kele8864879/ENEL417-Group8-/Project_Submittion/Website_Code/images.jpg

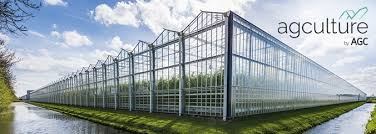
Project_Submittion/Website_Code/images.jpg
