kele8864879/ENEL417-Group8-/README.md

# ENEL417-Group8-

All of code file is saved in Project submittion. All of schamatic, block diagram, code diagram, and datasheet are saved in build demo. Please ignore other repository
