kele8864879/ENEL417-Group8-/Project_Submittion/Cubeide_Code/README.md

# ENEL417-Group8-

Main Board has the code for all system except light elevation part because the light elevation part is written in
second board
