kele8864879/ENEL417-Group8-/Project_Submittion/Cubeide_Code/417_Project (Main_Board)/Read_me.txt

It is the code for main borad. Main board take charge of every function unless light elevation.
