kele8864879/ENEL417-Group8-/Project_Submittion/Cubeide_Code/417_Project_ligh_elevation_(Second Board)/Read_me.txt

It is the second board code. The second board is responsible for the light elevation. It receive 00, 01 ,10, 11 GPIO
Information from main board, then it lift LED bar to 4cm, 8cm, 12cm, 16cm.
