kele8864879/ENEL417-Group8-/Build_demo/Block Diagrams/System Function Diagram.docx

1. System Block Diagram

Keyboard and LCD

Micro-controller

Temperature module

Heating/Cooling function

Illumination function

Illumination module

Watering function

Humidity module

Distance module

Lifting Function

Database

Remote control/HMI

2. Temperature Part Block Diagram

Heater and Fan

Dual High- power Mosfet

Cooling Fan

24V power supply

Dual High- power Mosfet

Keyboard Input

Micro-controller

LM 35 Temperature senor

Analog to Digital Converter

3. Watering Part Block Diagram

5V DC water pump

Remote Control

Keyboard Input

Analog to Digital Converter

Micro-controller

5V Relay

Moisture sensors

4. Illumination Part Block Diagram

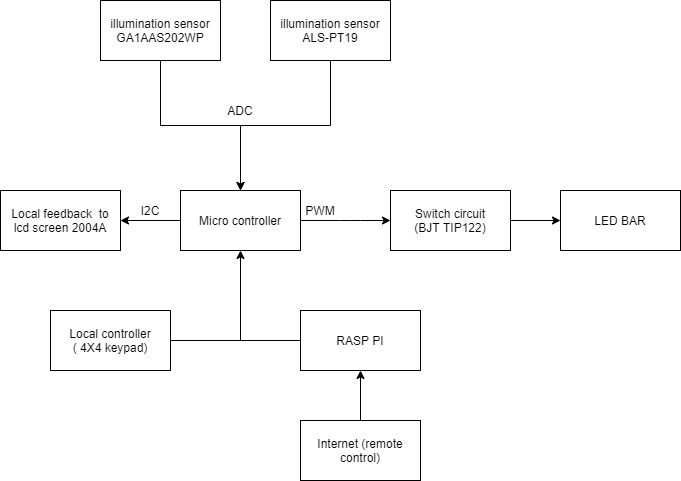
[picture p2: figure]

5. Lifting Part Block Diagram

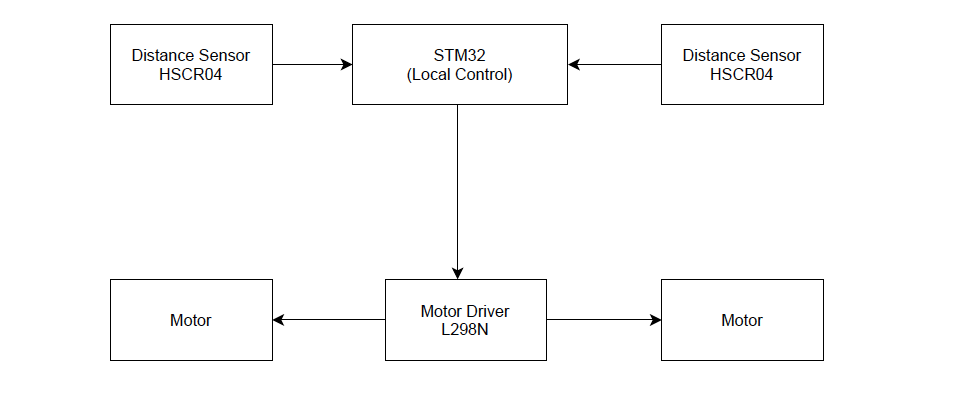
[picture p3: figure]

6. Remote Control Block Diagram

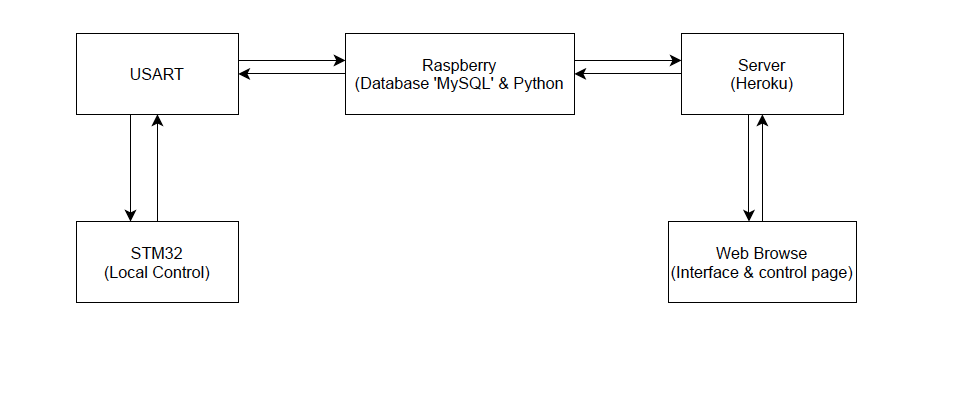
[picture p4: figure]

7. Local Control Block Diagram

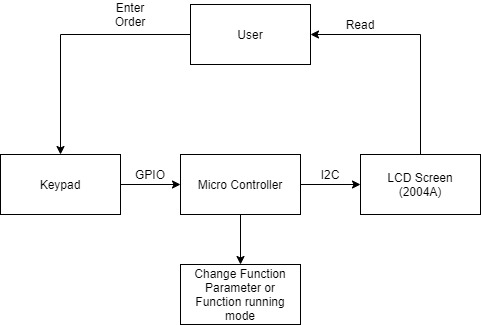
[picture p5: figure]
