kele8864879/ENEL417-Group8-/Build_demo/Code diagrams & pseudo-code/website_diagram.pdf

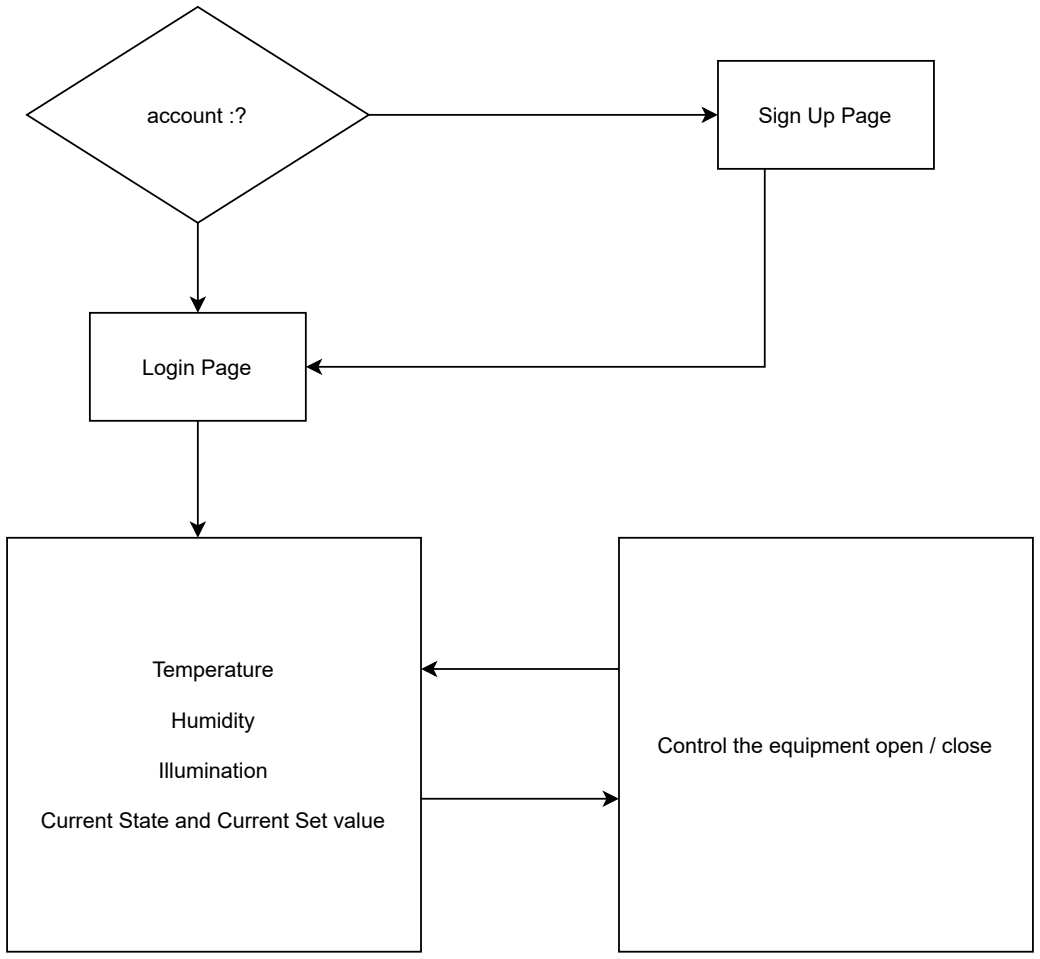
[picture p6: figure]
Temperature; Humidity; Illumination; Current State and Current Set value; Control the equipment open / close; account :?; Sign Up Page; Login Page
