kele8864879/ENEL417-Group8-/Build_demo/Code diagrams & pseudo-code/Total main running logic.pdf

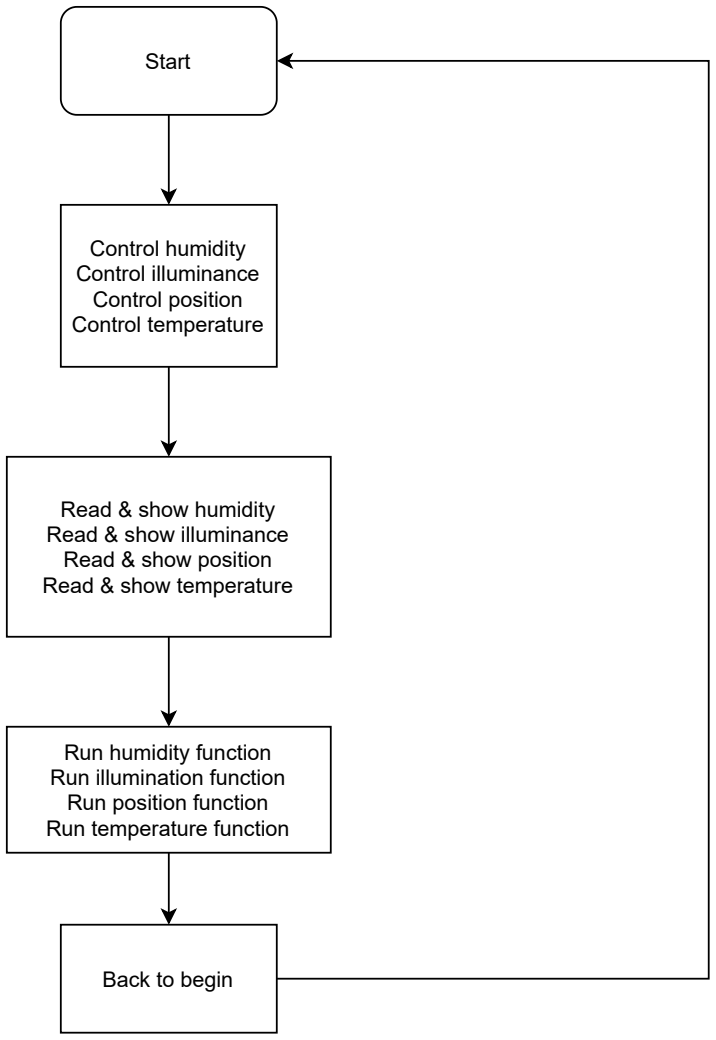
[picture p7: figure]
Control humidity Control illuminance Control position Control temperature; Read & show humidity Read & show illuminance Read & show position Read & show temperature; Run humidity function Run illumination function Run position function Run temperature function; Start; Back to begin
