kele8864879/ENEL417-Group8-/Build_demo/Code diagrams & pseudo-code/Remote_Control_Flow_Chart.pdf

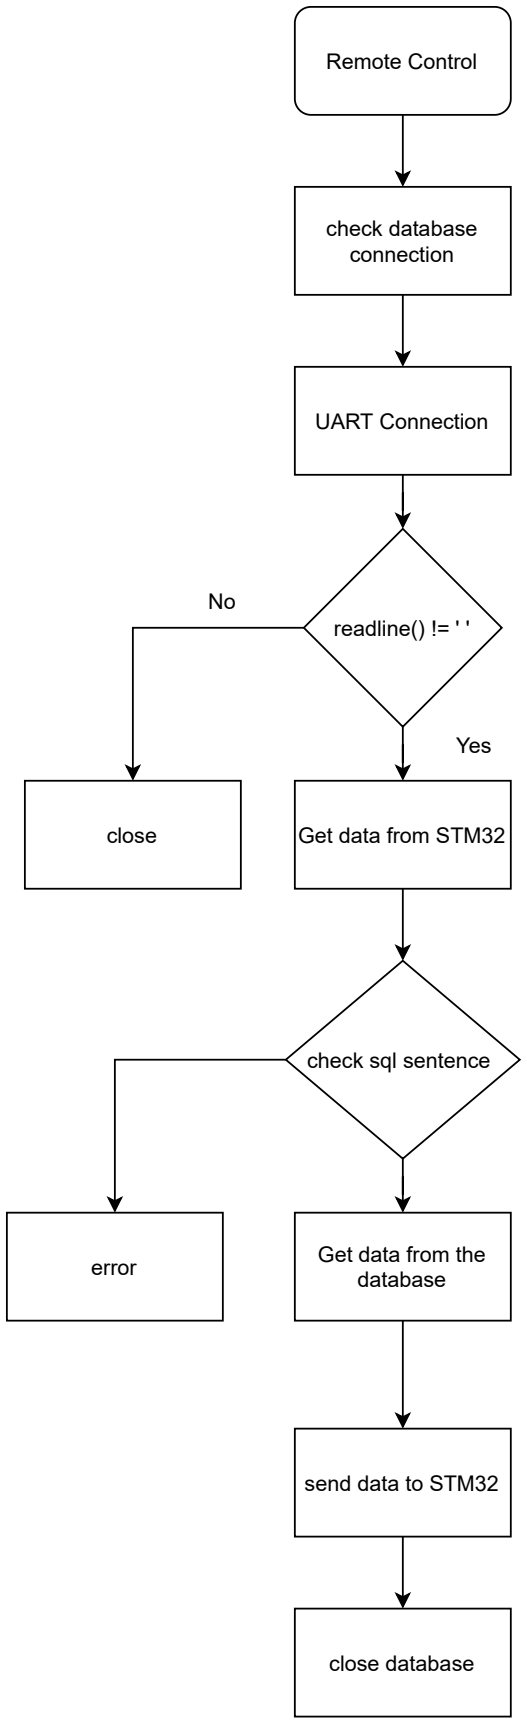
[picture p8: figure]
check database connection; Remote Control; UART Connection; readline() != ' '; close; Get data from STM32; check sql sentence; Get data from the database error; send data to STM32; Yes; close database
