kele8864879/ENEL417-Group8-/Build_demo/Circuit/CIRCUIT.pdf

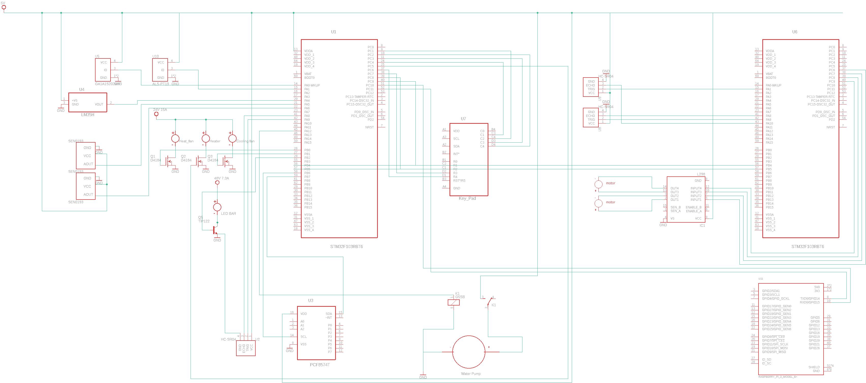
[picture p10: page 1]
