kele8864879/ENEL417-Group8-/Build_demo/Code diagrams & pseudo-code/Lifting_Flow_Chart.pdf

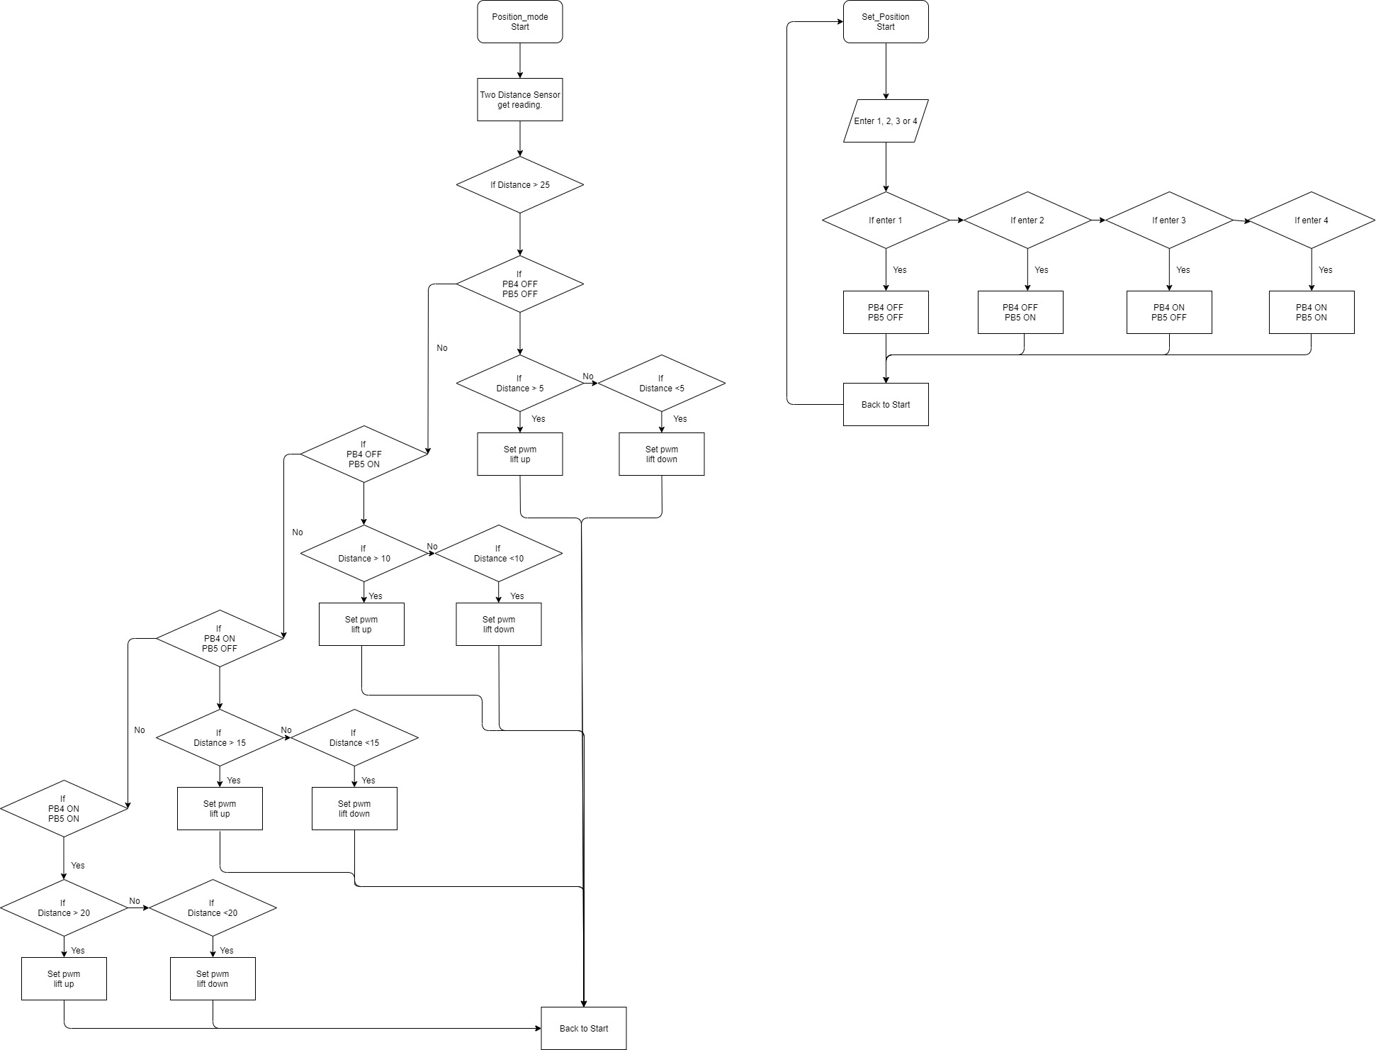
[picture p11: page 1]
