kele8864879/ENEL417-Group8-/Build_demo/Code diagrams & pseudo-code/illumination_flow_chart.pdf

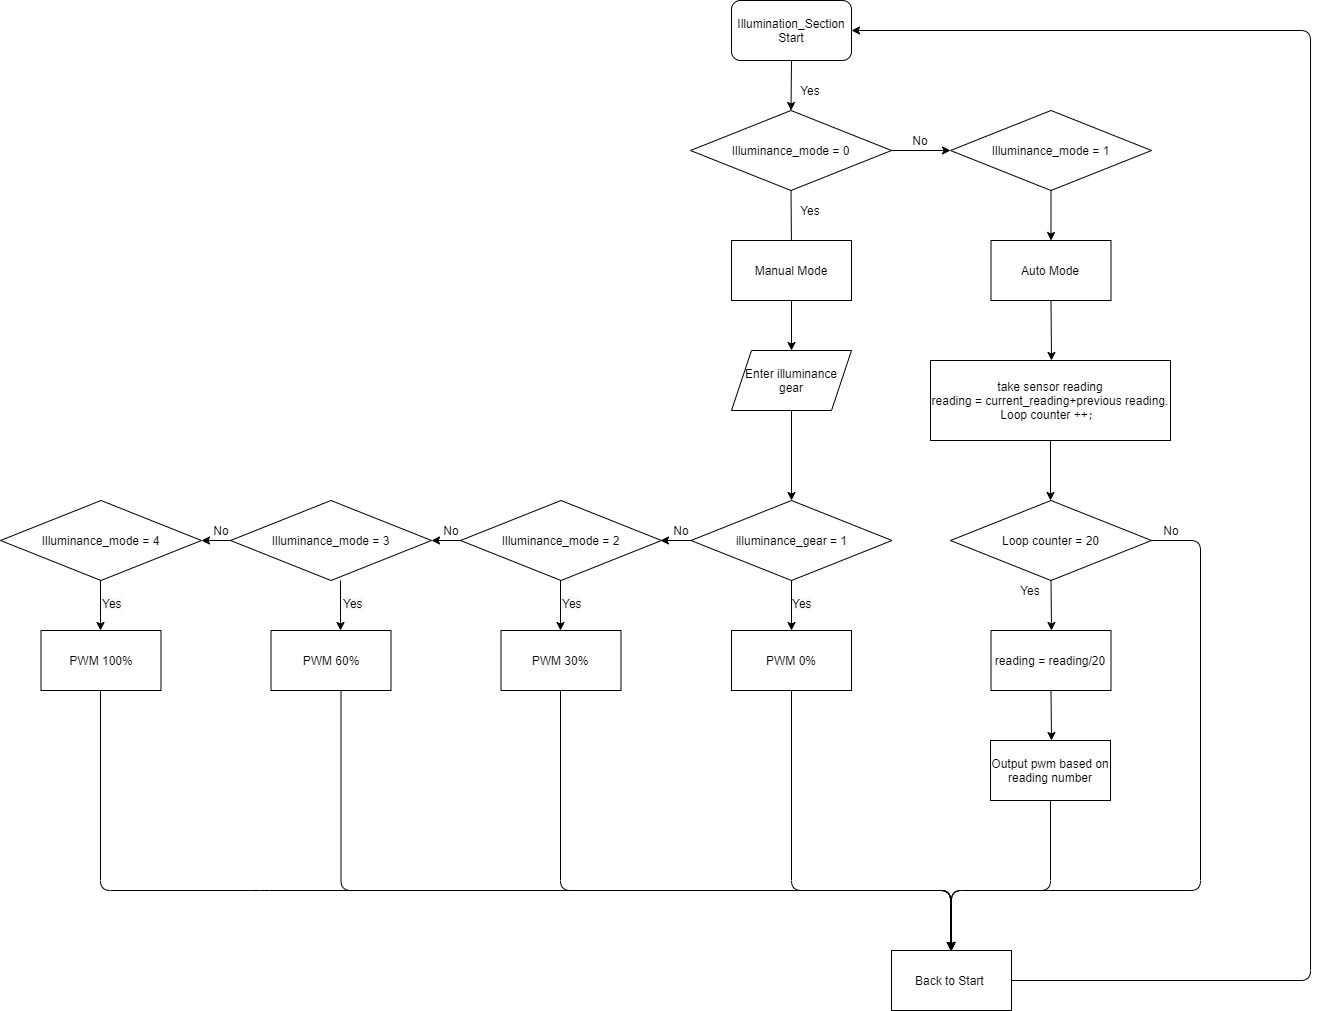
[picture p12: page 1]
