kele8864879/ENEL417-Group8-/Build_demo/Code diagrams & pseudo-code/Local_Control_Floa_Chart.pdf

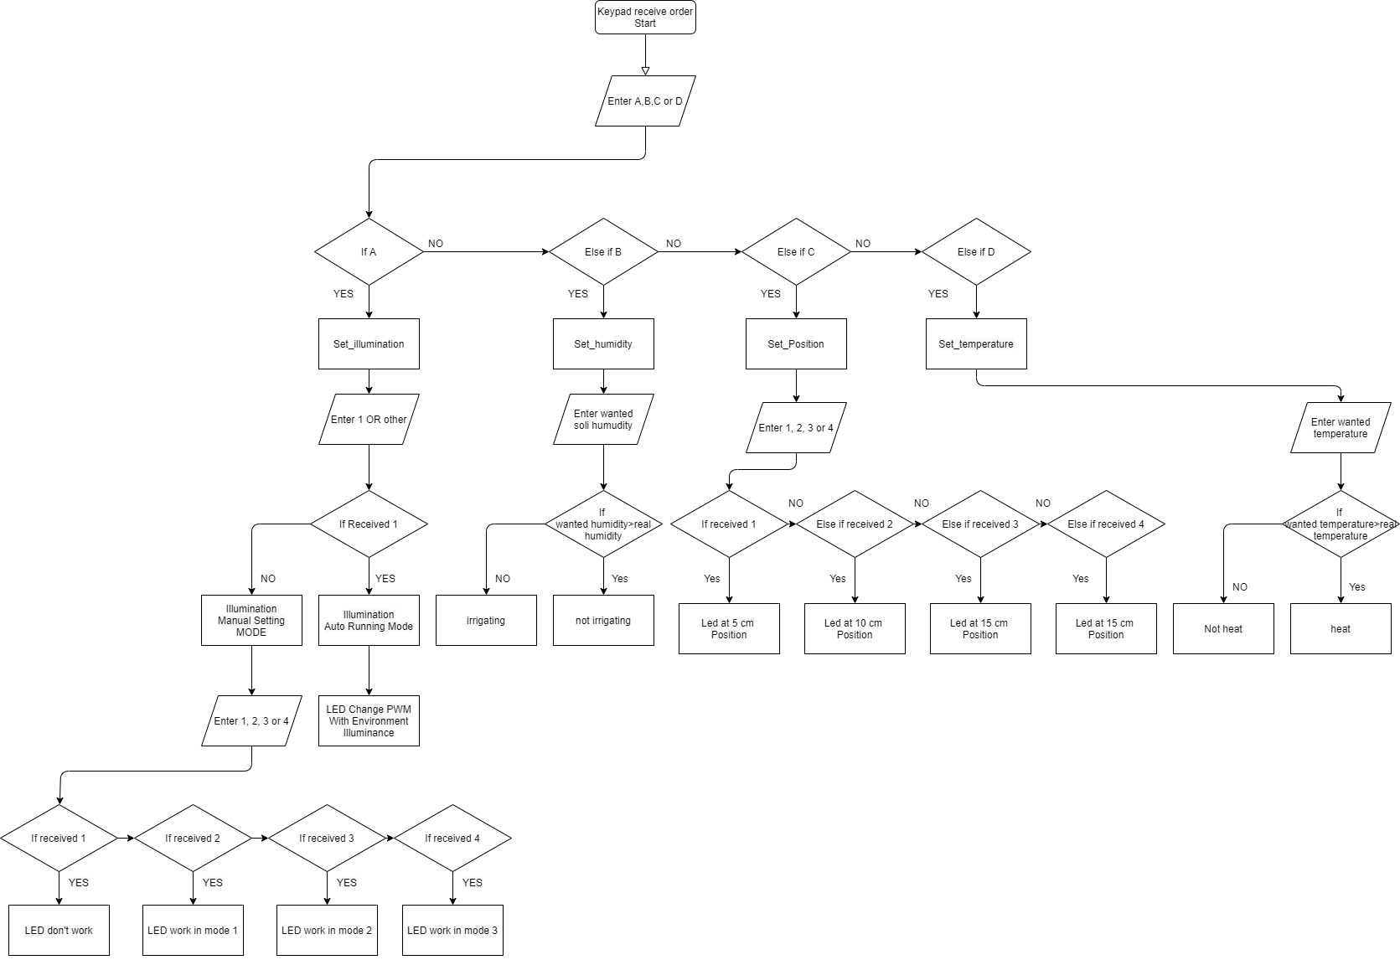
[picture p13: page 1]
