kele8864879/ENEL417-Group8-/Build_demo/Code diagrams & pseudo-code/database.pdf

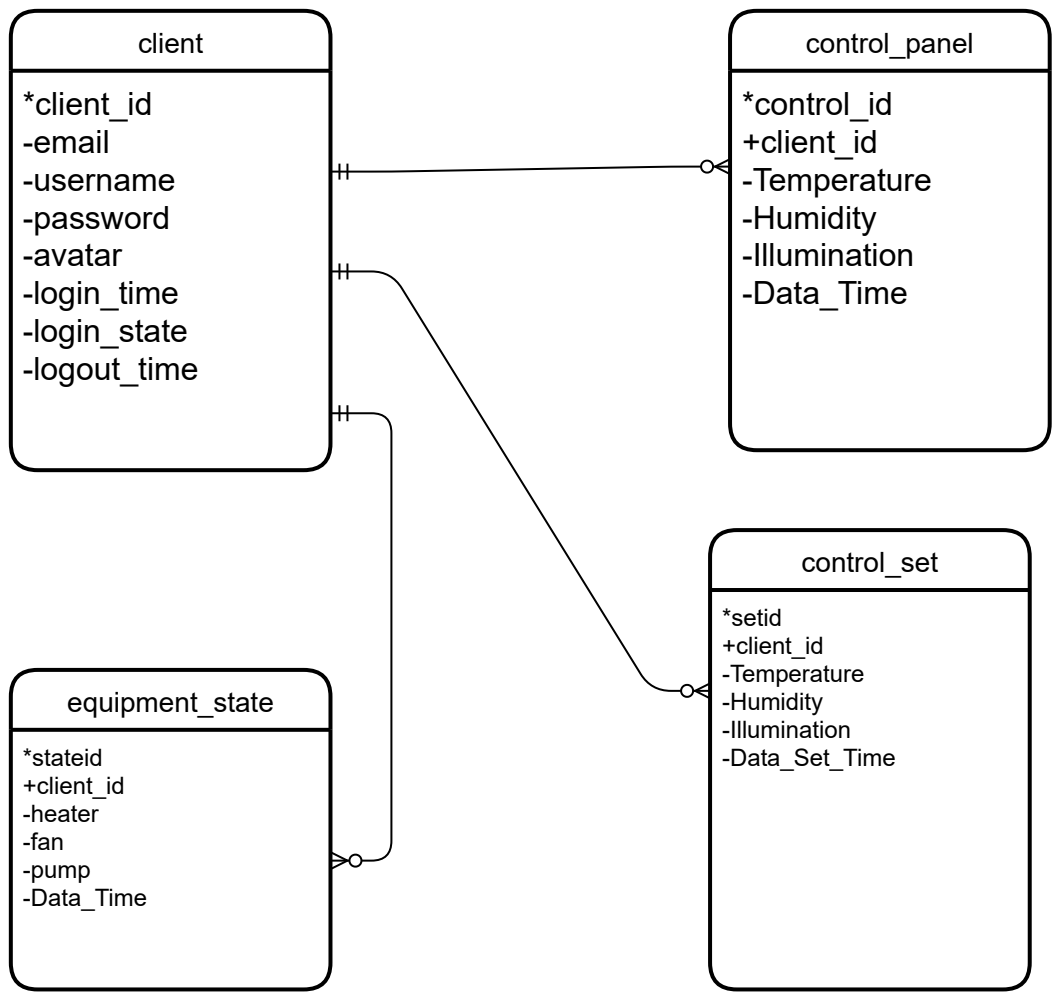
[picture p14: page 1]
client; *client_id -email -username -password -avatar -login_time -login_state -logout_time; control_panel; *control_id +client_id -Temperature -Humidity -Illumination -Data_Time; control_set; *setid +client_id -Temperature -Humidity -Illumination -Data_Set_Time; equipment_state; *stateid +client_id -heater -fan -pump -Data_Time
