kele8864879/ENEL417-Group8-/Build_demo/Code diagrams & pseudo-code/humidity_code_diagram.pdf

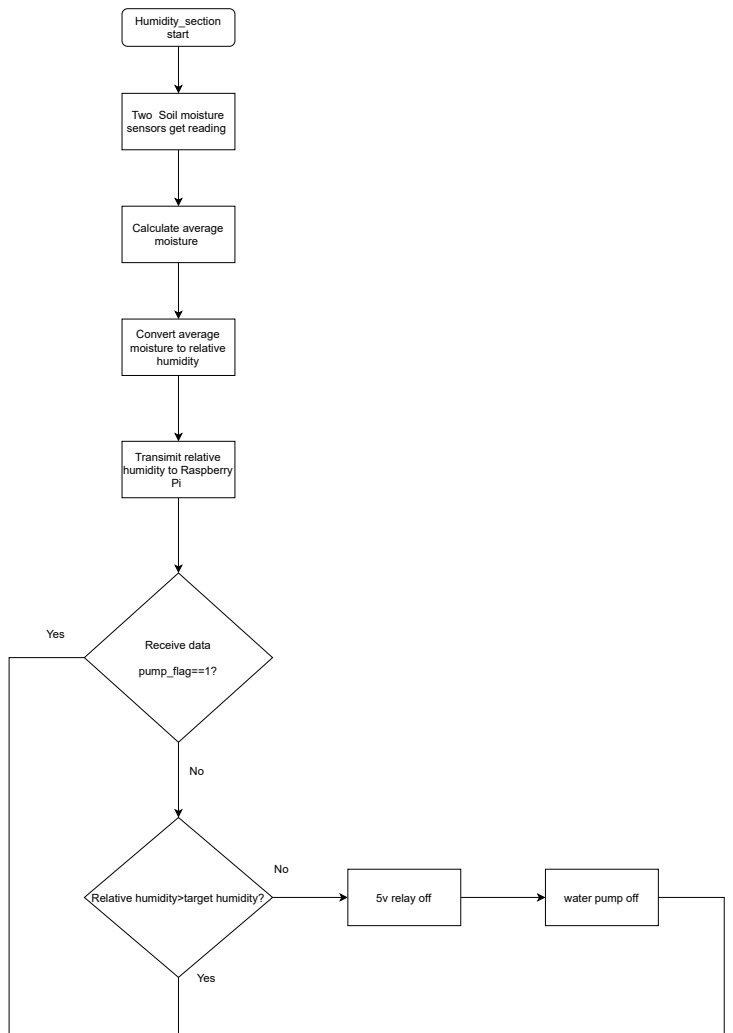
[picture p15: page 1]
Humidity_section start; Calculate average moisture; Relative humidity>target humidity?; 5v relay off; water pump off; Yes; Receive data; pump_flag==1?

Two Soil moisture
sensors get reading

Convert average
moisture to relative
humidity

Transimit relative
humidity to Raspberry

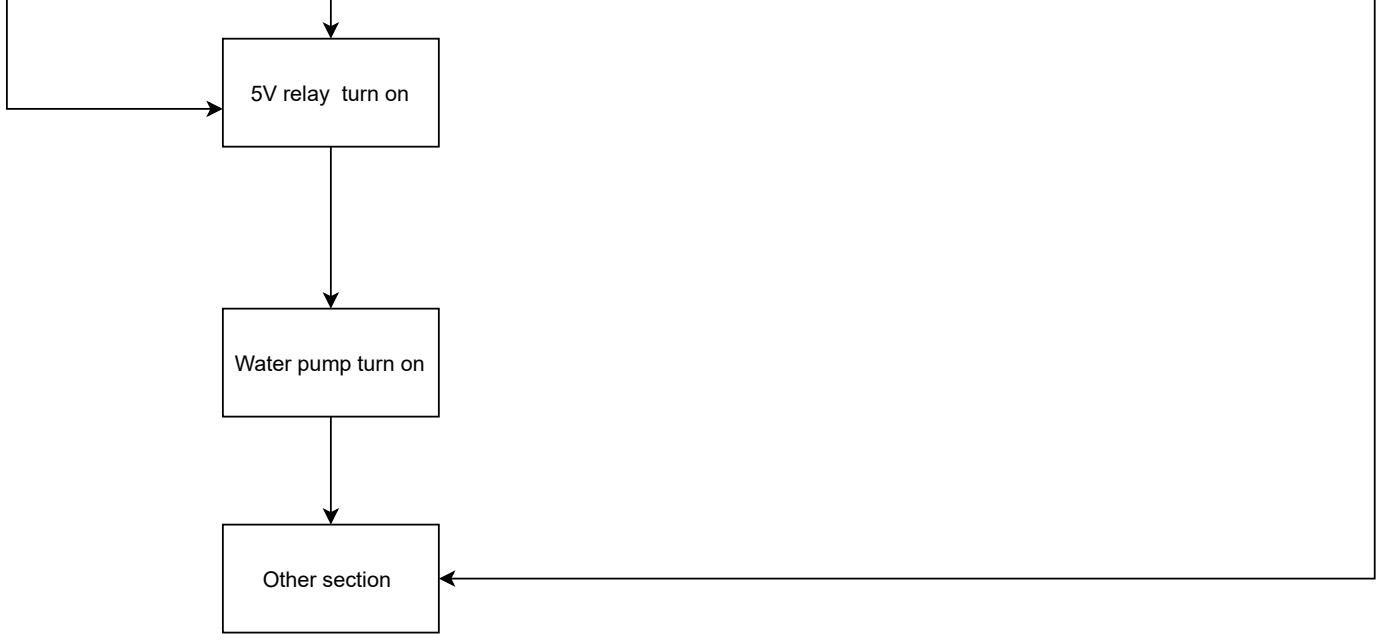
[picture p16: figure]
5V relay turn on; Water pump turn on; Other section
