kele8864879/ENEL417-Group8-/Fuyang/untitled.sch

## EAGLE design Fuyang/untitled.sch (2021-03-26)

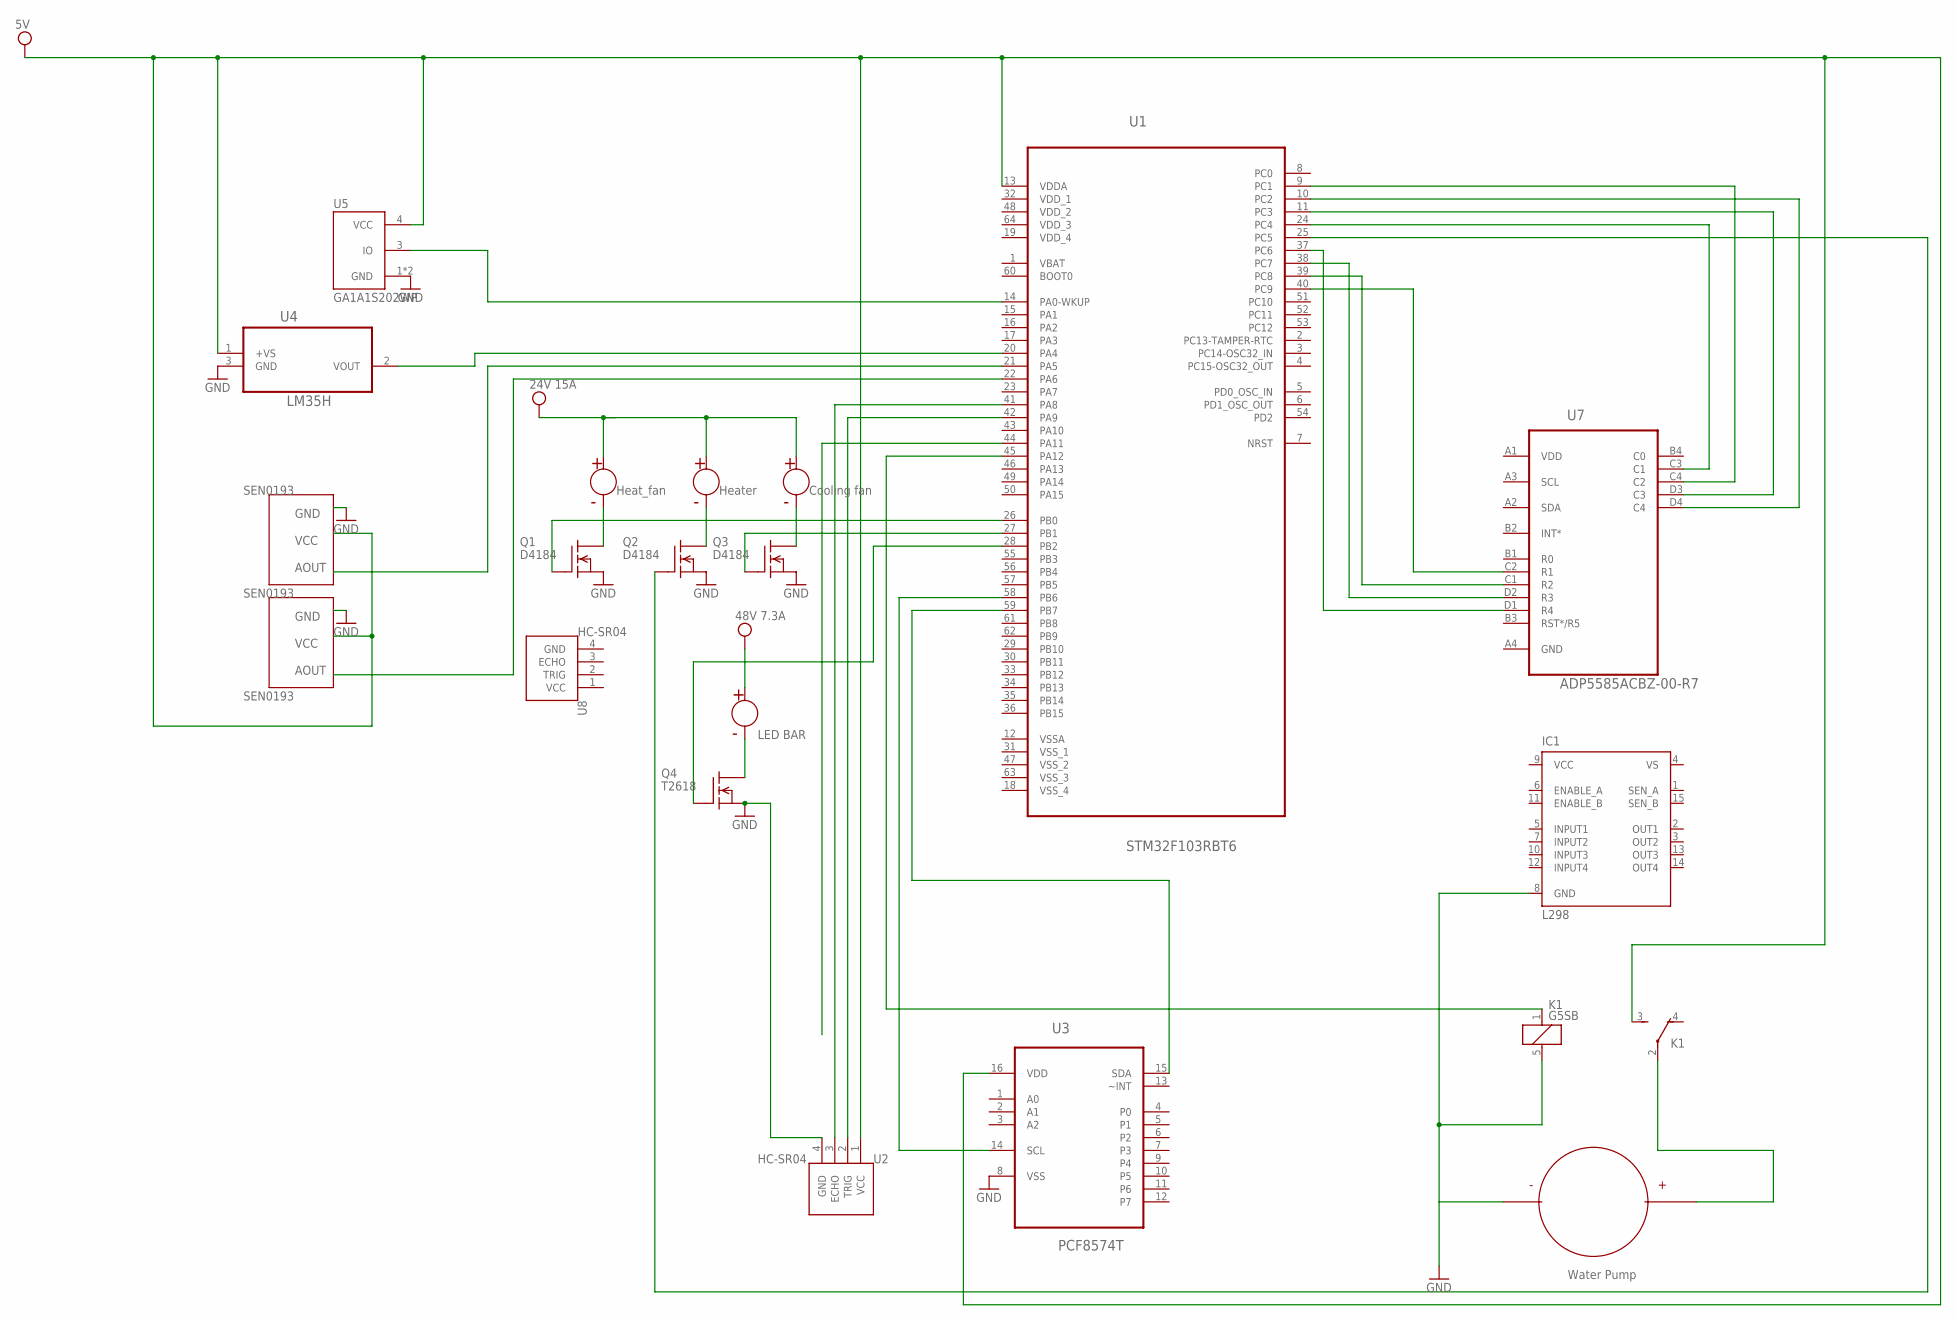
[picture p17: schematic untitled.sch]

Parts:
IC1: L298; MULTIWATT-15
K1: G5SB
Q1, Q2, Q3: D4184; TO92
Q4: T2618; TO92
U1: STM32F103RBT6; QFP50P1200X1200X160-64N
U2, U8: HC-SR04; XCVR_HC-SR04
U3: PCF8574T; SOIC127P1032X265-16N
U4: LM35H; TO127P543X266-3P
U5: GA1A1S202WP; XDCR_GA1A1S202WP
U7: ADP5585ACBZ-00-R7; BGA16C40P4X4_159X159X54

Connections:
GND: IC1.8 (GND), K1.5 (2), Q1.1 (S), Q2.1 (S), Q3.1 (S), Q4.1 (S), U2.4 (GND), U3.8 (VSS), U4.3 (GND), U5.1 (GND)
unnamed: U1.14 (PA0-WKUP), U5.3 (IO)
unnamed: U1.20 (PA4), U4.2 (VOUT)
unnamed: K1.1, U1.45 (PA12)
unnamed: U1.24 (PC4), U7.C3 (C1)
unnamed: Q1.2 (G), U1.26 (PB0)
unnamed: Q2.2 (G), U1.25 (PC5)
unnamed: Q3.2 (G), U1.27 (PB1)
unnamed: Q4.2 (G), U1.28 (PB2)
unnamed: U1.41 (PA8), U2.3 (ECHO)
unnamed: U1.42 (PA9), U2.2 (TRIG)
unnamed: U1.58 (PB6), U3.14 (SCL)
unnamed: U1.59 (PB7), U3.15 (SDA)
unnamed: U1.40 (PC9), U7.C2 (R1)
unnamed: U1.39 (PC8), U7.C1 (R2)
unnamed: U1.38 (PC7), U7.D2 (R3)
unnamed: U1.37 (PC6), U7.D1 (R4)
unnamed: U1.9 (PC1), U7.C4 (C2)
unnamed: U1.11 (PC3), U7.D3 (C3)
unnamed: U1.10 (PC2), U7.D4 (C4)
VCC: K1.3 (S), U1.13 (VDDA), U2.1 (VCC), U3.16 (VDD), U4.1 (+VS), U5.4 (VCC)

Notes on the sheet:
GND VCC AOUT
SEN0193
Heat_fan
Heater
Cooling fan
LED BAR
Water Pump
