kele8864879/ENEL417-Group8-/Zhelin/main.c

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
/* Includes ------------------------------------------------------------------*/
#include "main.h"
#include "adc.h"
#include "dma.h"
#include "i2c.h"
#include "tim.h"
#include "usart.h"
#include "gpio.h"

/* USER CODE BEGIN Includes */
#include "stdio.h"	//printf function
#include "string.h"
#include "stdlib.h"
#include <math.h>
/* USER CODE END Includes */


void SystemClock_Config(void);
/* USER CODE BEGIN 0 */
#ifdef __GNUC__
#define PUTCHAR_PROTOTYPE int __io_putchar(int ch)
#else
#define PUTCHAR_PROTOTYPE int fputc(int ch, FILE *f)
#endif

PUTCHAR_PROTOTYPE
{
    HAL_UART_Transmit(&huart2, (uint8_t *)&ch, 1 , 0xffff);
    return ch;
}

#define PB4_ON HAL_GPIO_WritePin(GPIOB, GPIO_PIN_4, GPIO_PIN_SET); //
#define PB4_OFF HAL_GPIO_WritePin(GPIOB, GPIO_PIN_4, GPIO_PIN_RESET); //
#define PB5_ON HAL_GPIO_WritePin(GPIOB, GPIO_PIN_5, GPIO_PIN_SET); //
#define PB5_OFF HAL_GPIO_WritePin(GPIOB, GPIO_PIN_5, GPIO_PIN_RESET); //

uint32_t IC_Val1 = 0;
uint32_t IC_Val2 = 0;
uint32_t Difference = 0;
uint8_t Is_First_Captured = 0;  // is the first value captured ?
uint8_t Distance  = 0;
// dma adc_buffer
uint16_t adc_buf[4];



//humidity part
const float air_humidity=3400;
const  float water_humidity=1680;
uint8_t key;
float humidity;
float humidity1;
char RH[10];
char set_humidity[10];	//for humidity function
char set_data[10]; 		// for wanted distance, light power, and distance
//int light_power = 0;
int position_gear;
int position_flag = 1;
float ilu_mode; //0 for auto mode, 1 for manual gear
float target_TEMP = 19;
float target_RH=40;
float avg_humidity;
int pump_flag=0;
int fan_flag=0;
int heater_flag=0;
////////////////////////////////////////////
uint8_t cliBufferTX[200];
uint8_t cliBufferRX[11];

/*
void Opearation_Fan() //括号内添加网页传过来的参数
{
	if(fan_flag == '1')
	{
		HAL_GPIO_WritePin(GPIOA,GPIO_PIN_12,GPIO_PIN_RESET); //Fans GPIOA OPEN
		__HAL_TIM_SET_COMPARE(&htim3,TIM_CHANNEL_3,3) pwm 50%

	}
	else if (fan_flag == '0')
	{
		HAL_GPIO_WritePin(GPIOA,GPIO_PIN_12,GPIO_PIN_RESET); //Fans GPIOA CLOSE
		__HAL_TIM_SET_COMPARE(&htim3,TIM_CHANNEL_3,3) pwm off
	}
	else
	{
		//自动控制
		//target_temp 获取用户想要的阈值
		//set fan_flag == 2
	}

}

void Operation_Heater() //括号内添加网页传过来的参数
{
	if(heater_flag == '1')
	{
		HAL_GPIO_WritePin(GPIOA,GPIO_PIN_12,GPIO_PIN_RESET); //Heater GPIOA OPEN
		__HAL_TIM_SET_COMPARE(&htim3,TIM_CHANNEL_3,3) pwm 50% //设置pwm在50%


	}
	else if(heater_flag == '0')
	{
		HAL_GPIO_WritePin(GPIOA,GPIO_PIN_12,GPIO_PIN_RESET); //Heater GPIOA CLOSE
		__HAL_TIM_SET_COMPARE(&htim3,TIM_CHANNEL_3,3) pwm off
	}
	else
	{
		//set heater_flag == 2
		//自动控制
		//target_temp 获取用户想要的阈值
	}
}
*/



void Humidity_Read(void)
{
	               humidity= adc_buf[2];//读取湿度
	               humidity1=adc_buf[3];
	               avg_humidity=(humidity+humidity1)/2;
	             //  printf(" humidity is %.1f v\t\r\n",humidity);
	            //   printf(" humidity is %.1f v\t\r\n",humidity1);
			       if(avg_humidity>air_humidity)//读取的温度与比较空气湿度比较
			       {
			    	   avg_humidity=0;
			       }

			       else if( water_humidity<humidity&&humidity< air_humidity)//读取的湿度与空气湿度和水里的湿度比较
			       {
			    	   avg_humidity=(1-(avg_humidity-water_humidity)/(air_humidity-water_humidity))*100;
			       }
			       else
			       {
			    	   avg_humidity=100;
			       }
			       sprintf(RH,"%.1f%%", avg_humidity);

}

void humidity_run()
{
			       if((avg_humidity<target_RH)||(pump_flag==1))
			       {
			    	   HAL_GPIO_WritePin(GPIOA,GPIO_PIN_12,GPIO_PIN_RESET);
			       }

			       else if(avg_humidity>=target_RH||pump_flag==0)
				   {
			    	   HAL_GPIO_WritePin(GPIOA,GPIO_PIN_12,GPIO_PIN_SET);
				   }

}
void set_humidity_mode()
{

	if(key=='A')
	{
					  int i=0;
					  int temp=1;
					  lcd_clear();
					  lcd_put_cur(0,0);
					  lcd_send_string("set humidity mode");
					  lcd_put_cur(1,0);
					  lcd_send_string("enter value:");
					  while(key!='*')
					  {
					 	 key=read_keypad();
					 	 target_RH=0;
					 	 if(key!='E')
					 	  {
					 	    lcd_send_data(key);
					 	    set_humidity[i]=key;
					 	    i++;
					 	  }
					 	  HAL_Delay(1000);

					 	  if(key=='*')
					 	  {
					 	     int counter=0;
					 	     int flag=0;
					 	     while(set_humidity[flag]!='*')
					 	     {
					 	    	   flag++;
					 	    	   counter++;
					 	     }
					 	    for(int j=0;j<=counter-1;j++)
					 	    {
					 	    	target_RH+=(set_humidity[counter-1-j]-'0')*temp;
					 	    	temp=temp*10;
					 	    }

					 	    	 lcd_clear();
					 	    	 lcd_put_cur(0,0);
					 	    	 if(target_RH>100||target_RH<0)
					 	    	 {
					 	    		 lcd_send_string("wrong input, the range is from 0 to 100");
					 	    		 target_RH=50;
					 	    	 }

					 	    }
					 	   }

					 	         HAL_Delay(1000);
					 	        lcd_clear();
					 	         key=' ';
		}

}

void set_illuminance_mode()
{
	char* buffer[2];
	 int i=0;
	 int temp=1;
	 ilu_mode;
	 	 	 	 	 	 lcd_clear();
						 lcd_put_cur(0,0);
						 lcd_send_string("set illuminance mode");
						 lcd_put_cur(1,0);
						 lcd_send_string("enter value:");
						  while(key!='*')
						  {
						 	 key=read_keypad();
						 	 ilu_mode=0;
						 	 if(key!='E')
						 	  {
						 	    lcd_send_data(key);
						 	    set_data[i]=key;
						 	    i++;
						 	  }
						 	  HAL_Delay(100);

						 	  if(key=='*')
						 	  {
						 	     int counter=0;
						 	     int flag=0;
						 	     while(set_data[flag]!='*')
						 	     {
						 	    	   flag++;
						 	    	   counter++;
						 	     }
						 	    for(int j=0;j<=counter-1;j++)
						 	    {
						 	    	ilu_mode+=(set_data[counter-1-j]-'0')*temp;
						 	    	temp=temp*10;
						 	    }

						 	    	 lcd_clear();
						 	    	 lcd_put_cur(0,0);

						 	    }
						 	   }
						 	         HAL_Delay(1000);
						 	         key=' ';


}

void set_position_mode()
{
	char* buffer[2];
	position_gear=0;

						  int i=0;
						  int temp=1;
						  lcd_clear();
						  lcd_put_cur(0,0);
						  lcd_send_string("set position mode");
						  lcd_put_cur(1,0);
						  lcd_send_string("enter value:");
						  while(key!='*')	//判断是否确认
						  {
						 	 key=read_keypad();
						 	 //set_value=0;
						 	 if(key!='E')
						 	  {
						 	    lcd_send_data(key);
						 	   set_data[i]=key;
						 	    i++;
						 	  }
						 	  HAL_Delay(100);

						 	  if(key=='*')
						 	  {
						 	     int counter=0;	//Array position number for for loop
						 	     int flag=0;	//Array position
						 	     while(set_data[flag]!='*')	//IF present location is not the final '*'
						 	     {
						 	    	   flag++;		//judge array length
						 	    	   counter++;
						 	     }
						 	    for(int j=0;j<=counter-1;j++)
						 	    {
						 	    	position_gear+=(set_data[counter-1-j]-'0')*temp;
						 	    	temp=temp*10;
						 	    }

						 	    	 lcd_clear();
						 	    	 lcd_put_cur(0,0);
						 	    	 if (position_gear==1)
						 	    	 {
						 	    		position_flag=1;
						 	    		PB4_OFF;
										PB5_OFF;
							 	    	 lcd_clear();
							 	    	 lcd_put_cur(0,0);
							 	    	 lcd_send_string("Correct input, Now in Position Gear 1");
							 	    	position_gear=0;

						 	    	 }
						 	    	 else if(position_gear==2)
						 	    	 {
						 	    		position_flag=2;
							 	    		PB4_OFF;
											PB5_ON;
								 	    	 lcd_clear();
								 	    	 lcd_put_cur(0,0);
								 	    	 lcd_send_string("Correct input, Now in Position Gear 2");
								 	    	position_gear=0;
						 	    	 }
						 	    	 else if(position_gear==3)
						 	    	 {
						 	    		position_flag=3;
							 	    		PB4_ON;
											PB5_OFF;
								 	    	 lcd_clear();
								 	    	 lcd_put_cur(0,0);
								 	    	 lcd_send_string("Correct input, Now in Position Gear 3");
								 	    	position_gear=0;
						 	    	 }
						 	    	 else if(position_gear==4)
						 	    	 {
						 	    		position_flag=4;
							 	    		PB4_ON;
											PB5_ON;
								 	    	 lcd_clear();
								 	    	 lcd_put_cur(0,0);
								 	    	 lcd_send_string("Correct input, Now in Position Gear 4");
								 	    	position_gear=0;
						 	    	 }
						 	    	 else
									 {
						 	  		  lcd_send_string("Wrong input, please enter again");
									 }

						 	    	//while(1);

						 	    }
						 	   }
						 	         HAL_Delay(1000);
						 	        lcd_clear();
						 	         key=' ';

}
void set_temperature_mode()
{
	char* buffer[2];
	 int i=0;
	 int temp=1;

	 	 	 	 	 	 lcd_clear();
						 lcd_put_cur(0,0);
						 lcd_send_string("set temperature mode");
						 lcd_put_cur(1,0);
						 lcd_send_string("enter temp");
						  while(key!='*')
						  {
						 	 key=read_keypad();
						 	target_TEMP=0;
						 	 if(key!='E')
						 	  {
						 	    lcd_send_data(key);
						 	    set_data[i]=key;
						 	    i++;
						 	  }
						 	  HAL_Delay(100);

						 	  if(key=='*')
						 	  {
						 	     int counter=0;
						 	     int flag=0;
						 	     while(set_data[flag]!='*')
						 	     {
						 	    	   flag++;
						 	    	   counter++;
						 	     }
						 	    for(int j=0;j<=counter-1;j++)
						 	    {
						 	    	target_TEMP+=(set_data[counter-1-j]-'0')*temp;
						 	    	temp=temp*10;
						 	    }

						 	    	 lcd_clear();
						 	    	 lcd_put_cur(0,0);

						 	    }
						 	   }
						 	         HAL_Delay(1000);
						 	         key=' ';


}
/* USER CODE END 0 */

/**
  * @brief  The application entry point.
  * @retval int
  */
int main(void)
{
  /* USER CODE BEGIN 1 */
	float PA0_Vlotage;
	float PA1_Vlotage;
	float led_pwm = 250;
	float led_previous_reading = 0;
	float led_current_reading = 0;
	float counter_led_reading = 0;
	char* buffer[2];
	int number = 0;
	float mean, sum;
	float TEMP = 0;
	float TEMP_LASTVALUE = 0;
	int keep_state = 0;
	uint16_t  hadc2_value = 0;
	float hadc2_vol = 0;
	int TEMP_Lock = 0;
	int HYSTERESIS = 0 ;
	int HYSTERESIS_FAN = 1;
	int TIM_4;
	int flag=0;
//	int led_error_mode=0;
	int led_mode_lock=0;


  /* USER CODE END 1 */

  /* MCU Configuration--------------------------------------------------------*/

  /* Reset of all peripherals, Initializes the Flash interface and the Systick. */
  HAL_Init();

  /* Configure the system clock */
  SystemClock_Config();

  /* Initialize all configured peripherals */
  MX_GPIO_Init();
  MX_DMA_Init();
  MX_ADC1_Init();
  MX_ADC2_Init();
  MX_TIM2_Init();
  MX_TIM3_Init();
  MX_I2C1_Init();
  MX_TIM4_Init();
  MX_USART3_UART_Init();
  MX_USART2_UART_Init();
  /* USER CODE BEGIN 2 */
  HAL_GPIO_WritePin(GPIOA,GPIO_PIN_12,GPIO_PIN_SET);
  HAL_ADC_Start_DMA(&hadc1, adc_buf, 4);//&hadc1, saved in adc_buf, length 3


  HAL_TIM_PWM_Start(&htim3,TIM_CHANNEL_3);
  HAL_TIM_PWM_Start(&htim2,TIM_CHANNEL_3);  //illuminance CHANNEL
  HAL_TIM_PWM_Start(&htim3,TIM_CHANNEL_4); // 高频 黄灯 给heater fan PB1
 // HAL_TIM_PWM_Start(&htim4,TIM_CHANNEL_3);	//motor pwm zheng zhuan
 // HAL_TIM_PWM_Start(&htim4,TIM_CHANNEL_4);	//motor pwm fanzhuan
  lcd_init();
  //HAL_TIM_IC_Start_IT(&htim1, TIM_CHANNEL_1);
	//PB4_OFF;
	//PB5_OFF;
	//position_gear = 1;


  /* USER CODE END 2 */

  /* Infinite loop */
  /* USER CODE BEGIN WHILE */
  while (1)
  {
    /* USER CODE END WHILE */

    /* USER CODE BEGIN 3 */
	   key=read_keypad();
	   if(key=='A'||key=='B'||key=='C'||key=='D')
	   {
		   if(key == 'A')
		   {
			   set_humidity_mode();
		   }
		   if(key == 'B')
		   {
			   led_mode_lock = 0;
			   set_illuminance_mode();
		   }
		   if(key == 'C')
		   {
			   set_position_mode();
		   }
		   if(key == 'D')
		   {
			   set_temperature_mode();
		   }
	   }

	  if(uwTick%1000==0)//reading section open
	  {
	  // Distance Sensor Reading to LCD

	  lcd_send_cmd (0x80|0x00);
	  lcd_send_string ("Dist= ");
	    sprintf(buffer, "%d", position_flag*5);
	    lcd_send_string(buffer);
	    lcd_send_string ("cm");

	  //HADC2 读取 LM35
	  	HAL_ADC_Start(&hadc2);
	  	HAL_ADC_PollForConversion(&hadc2, 50);


	  				//for(int i = 0; i < 10 ; i++)
	  				//{
	  		 	       if(HAL_IS_BIT_SET(HAL_ADC_GetState(&hadc2), HAL_ADC_STATE_REG_EOC))
	  		 	       {
	  		 	    	hadc2_value = HAL_ADC_GetValue(&hadc2);
	  		 	    	hadc2_vol = (float)(hadc2_value * 2.29/4096);
	  		 	     //   printf("\n hadc2 value is %.4f v\t\r\n",hadc2_vol);
	  		 	       }

	  		 		 // float calculate_mean(float PA4)


	  		 		  	if(number == 3)
	  		 		  	{
	  		 		  		float mean = sum / 3;
	  		 		  	//	printf("\n mean is %.4f v\t\r\n",mean);
	  		 		  		TEMP = mean;
	  		 		  		TEMP = TEMP*100;
	  		 		  		//printf("\n TEMP is %.4f v\t\r\n",TEMP);
	  		 		  		number = 0;
	  		 		  		sum = 0;
	  		 		  		mean = 0;
	  		 		  		//HAL_Delay(5000);
	  		 		  	}
	  		 		  	else
	  		 		  	{
	  		 		  		number = number + 1;
	  		 		  		sum = sum + hadc2_vol;
	  		 		  		//HAL_Delay(10);
	  		 		  	}
	  				//}
		  		 		// 预防误差读数
		  		 		 if((TEMP_LASTVALUE - TEMP > 1.5) || (TEMP - TEMP_LASTVALUE > 1.5))
		  		 		 {
		  		 			keep_state = 1;
		  		 		 }
		  		 		 if((keep_state == 1) && (TEMP_Lock == 0))
		  		 		 {
		  		 			TEMP = TEMP_LASTVALUE;
		  		 			TEMP_Lock ++;
		  		 		 }
		  		 		 if((keep_state == 1) && (TEMP_Lock == 5))
		  		 		 {
		  		 			keep_state = 0;
		  		 			TEMP_Lock = 0;
		  		 		 }
		  		 		 if((TEMP_Lock == 1) || (TEMP_Lock == 2)|| (TEMP_Lock == 3)|| (TEMP_Lock == 4))
		  		 		 {
		  		 			TEMP_Lock ++;
		  		 		 }
		 	  		 	if (keep_state == 0)
		 	  		 	{
		 	  		 		TEMP_LASTVALUE = TEMP;
		 	  		 	}


	  //LCD显示光照参数
	  	lcd_send_cmd (0x80|0x40);
		sprintf(buffer, "%.1f", PA1_Vlotage*140);
		lcd_send_string("LM:");
		lcd_send_string(buffer);
		//lcd_put_cur(0,0);

		//LCD显示LM35读数


		lcd_send_cmd (0x80|0x14);
		sprintf(buffer, "%.3f", TEMP);
		lcd_send_string("TEMP:");
		lcd_send_string(buffer);

		//HUMIDITY

		lcd_send_cmd (0x80|0x54);
		Humidity_Read();
		lcd_send_string("RH:");
		lcd_send_string(RH);



			    char data[100];
			    sprintf(data,"%.1f", avg_humidity);
			  	HAL_UART_Transmit(&huart3, data, strlen((char*)data),1000);
			  	strcpy((char *)cliBufferTX,", " );
			  	HAL_UART_Transmit(&huart3,cliBufferTX,strlen((char*)cliBufferTX),200);

			  	sprintf(data, "%.1f", PA1_Vlotage*140);
			  	HAL_UART_Transmit(&huart3, data, strlen((char*)data),1000);
			  	strcpy((char *)cliBufferTX,", " );
			  	HAL_UART_Transmit(&huart3,cliBufferTX,strlen((char*)cliBufferTX),200);

			  	sprintf(data, "%.1f", TEMP);
			  	HAL_UART_Transmit(&huart3, data, strlen((char*)data),1000);
				strcpy((char *)cliBufferTX,", " );
				HAL_UART_Transmit(&huart3,cliBufferTX,strlen((char*)cliBufferTX),200);

			  	sprintf(data, "%.1f", target_RH);
			    HAL_UART_Transmit(&huart3, data, strlen((char*)data),1000);
			    strcpy((char *)cliBufferTX,", " );
			    HAL_UART_Transmit(&huart3,cliBufferTX,strlen((char*)cliBufferTX),200);


			    sprintf(data, "%.1f",target_TEMP );
			    HAL_UART_Transmit(&huart3, data, strlen((char*)data),1000);
			    strcpy((char *)cliBufferTX,", " );
			    HAL_UART_Transmit(&huart3,cliBufferTX,strlen((char*)cliBufferTX),200);




			  	strcpy((char *)cliBufferTX,"\r\n " );
			  	HAL_UART_Transmit(&huart3,cliBufferTX,strlen((char *)cliBufferTX),200);

			  	HAL_UART_Receive_IT(&huart3,cliBufferRX,11);




	  }//reading section close


       // receive data


		//PWM led running logic
		  PA0_Vlotage = adc_buf[0]*(3.3/4096);
		  PA1_Vlotage = adc_buf[1]*(3.3/4096);
		 // __HAL_TIM_SET_COMPARE(&htim2,TIM_CHANNEL_3,999);
		 printf("\n PA0 Voltage is %.4f v\t\r\n",PA0_Vlotage);
		 // __HAL_TIM_SET_COMPARE(&htim2,TIM_CHANNEL_3,9999);
		 //printf("\n PA1 Voltage is %.4f v\t\r\n",PA1_Vlotage);
		// HAL_Delay(100);
		 if(ilu_mode!=1)
		 {
			 ilu_mode = 0;
		 }
		 if(ilu_mode == 0)
		 {
			 led_current_reading = PA0_Vlotage +  led_current_reading;
			 counter_led_reading++;
			 if (counter_led_reading == 20)
			 {

				 led_current_reading=led_current_reading/20;
				 __HAL_TIM_SET_COMPARE(&htim2,TIM_CHANNEL_3,led_current_reading*62000);
				 led_previous_reading = led_current_reading;
				 counter_led_reading=0;
				 led_current_reading=0;
				// HAL_Delay(200);
			 }
		 }
		 if(ilu_mode == 1 && led_mode_lock == 0)
		 {

			 	char* buffer[2];
			 	 int i=0;
			 	 int temp=1;
			 	 int ilu_mode_gear;
			 	 	 	 	 	 	 lcd_clear();
			 						 lcd_put_cur(0,0);
			 						 lcd_send_string("set ilu gear");
			 						 lcd_put_cur(1,0);
			 						 lcd_send_string("enter value:");
			 						  while(key!='*')
			 						  {
			 						 	 key=read_keypad();
			 						 	ilu_mode_gear=0;
			 						 	 if(key!='E')
			 						 	  {
			 						 	    lcd_send_data(key);
			 						 	    set_data[i]=key;
			 						 	    i++;
			 						 	  }
			 						 	  HAL_Delay(100);

			 						 	  if(key=='*')
			 						 	  {
			 						 	     int counter=0;
			 						 	     int flag=0;
			 						 	     while(set_data[flag]!='*')
			 						 	     {
			 						 	    	   flag++;
			 						 	    	   counter++;
			 						 	     }
			 						 	    for(int j=0;j<=counter-1;j++)
			 						 	    {
			 						 	    	ilu_mode_gear+=(set_data[counter-1-j]-'0')*temp;
			 						 	    	temp=temp*10;
			 						 	    }

			 						 	    	 lcd_clear();
			 						 	    	 lcd_put_cur(0,0);

			 						 	    }
			 						 	   }
			 						 	         HAL_Delay(100);
			 						 	         key=' ';
			if (ilu_mode_gear==1)
			{
				 __HAL_TIM_SET_COMPARE(&htim2,TIM_CHANNEL_3,10000);
			}
			else if (ilu_mode_gear==2)
			{
				__HAL_TIM_SET_COMPARE(&htim2,TIM_CHANNEL_3,9600);
			}
			else if (ilu_mode_gear==3)
			{
				__HAL_TIM_SET_COMPARE(&htim2,TIM_CHANNEL_3,7600);
			}
			else if (ilu_mode_gear==4)
			{
				__HAL_TIM_SET_COMPARE(&htim2,TIM_CHANNEL_3,0);
			}
			else
			{ lcd_clear();
			 lcd_put_cur(0,0);
			 lcd_send_string("Wrong input");
			}
			led_mode_lock = 1;
		 }

		 humidity_run();
		 //HAL_Delay(200);

		//

		//PWM HEATER Fan RUNNING 黄灯
		if ((TEMP > target_TEMP-2) && (TEMP < target_TEMP+2)) //温度大于 23 °C 并且小于25 °C PWM 50%
		{
			if (HYSTERESIS == 1)
			{
				__HAL_TIM_SET_COMPARE(&htim3,TIM_CHANNEL_4,0); // heater 100000HZ
			}

		}
		else if ((TEMP > target_TEMP-4)&&(TEMP < target_TEMP-2)) //温度大于 21 °C 并且小于23 °C PWM 80%
		{
			__HAL_TIM_SET_COMPARE(&htim3,TIM_CHANNEL_4,2);
		}

		else if (TEMP < target_TEMP-4) //温度小于 21 °C PWM 100%
				{
					__HAL_TIM_SET_COMPARE(&htim3,TIM_CHANNEL_4,0);
				}
		else __HAL_TIM_SET_COMPARE(&htim3,TIM_CHANNEL_4,11);

		//PWM FAN RUNNING 红灯
           // 远程控制风扇开关
           if(fan_flag==1)
            {
              __HAL_TIM_SET_COMPARE(&htim3,TIM_CHANNEL_3,0);//pwm 100%

            }
            else{

				if ((TEMP > target_TEMP) && (TEMP < target_TEMP+2)) //温度大于 25 °C 并且小于27 °C PWM 50%
				{
					if (HYSTERESIS == 0)
					{
						if (HYSTERESIS_FAN == 1)
						{
						__HAL_TIM_SET_COMPARE(&htim3,TIM_CHANNEL_3,6); // fan 100000HZ
							HYSTERESIS_FAN = 0;
						}
					}
				}
				else if ((TEMP > target_TEMP+2)&&(TEMP < target_TEMP+4)) //温度大于 27 °C 并且小于29 °C PWM 80%
				{
					__HAL_TIM_SET_COMPARE(&htim3,TIM_CHANNEL_3,3);
				}
				else if (TEMP >= target_TEMP+4) //温度大于 29 °C PWM 100%
						{
							__HAL_TIM_SET_COMPARE(&htim3,TIM_CHANNEL_3,0);
						}
				else
					__HAL_TIM_SET_COMPARE(&htim3,TIM_CHANNEL_3,11);

				if (TEMP < target_TEMP-1.5)
				{
					HYSTERESIS_FAN = 1;
				}
			}
				//Heater Running PB0
					if (TEMP < target_TEMP) //温度小于 25 °C HEATER打开
					{
						if (((HYSTERESIS == 0) && (TEMP < target_TEMP-2)))
						{
							HAL_GPIO_WritePin(GPIOC, GPIO_PIN_5, GPIO_PIN_SET);  // 打开PC5 蓝灯 高于27°关闭 低于23°打开

							HYSTERESIS = 1;
						}

					}
							else if (TEMP > target_TEMP)// 温度大于25 HEATER关闭
							{
								if ((HYSTERESIS == 1) && (TEMP > target_TEMP+2))
								{
									HAL_GPIO_WritePin(GPIOC, GPIO_PIN_5, GPIO_PIN_RESET); //关闭PC5
									HYSTERESIS = 0;
								}
							}
				//HAL_Delay(800);
//*/
					//water pump running code









  }
  /* USER CODE END 3 */
}

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
/* USER CODE BEGIN 4 */

void initialization()
{
	for(int i=0;i<10;i++)
	{
		cliBufferRX[i]=0;

	}
}





void HAL_UART_RxCpltCallback(UART_HandleTypeDef *huart)
{
	char delims[] = ",";
	char *result;
	char *result1;
	int p_flag;
	int f_flag;


    if(cliBufferRX[0]==1)
    {
		result = strtok(cliBufferRX, delims );
	    target_RH=atof(result);

		 result1 = strtok( NULL, delims );
		 target_TEMP=atof(result1);

		 p_flag = strtok( NULL, delims );
		 pump_flag=atoi(p_flag);

		 f_flag = strtok( NULL, delims );
		 fan_flag=atoi(f_flag);
    }


    p_flag = strtok( cliBufferRX, delims );
    pump_flag=atoi(p_flag);

    f_flag = strtok( NULL, delims );
    fan_flag=atoi(f_flag);

   // printf("333 is %.4f v\t\r\n",pump_flag);
   // printf("444 is %.4f v\t\r\n",fan_flag);

    initialization();

    /*result2 = strtok( NULL, delims );
    set_value=atof(result2);*/
}
/* USER CODE END 4 */
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
