kele8864879/ENEL417-Group8-/Fuyang/Src/main.c

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
/* Includes ------------------------------------------------------------------*/
#include "main.h"

/* USER CODE BEGIN Includes */
#include "lcd.h"
#include "keypad.h"
#include "string.h"
#include "stdio.h"

/* USER CODE END Includes */

ADC_HandleTypeDef hadc1;
DMA_HandleTypeDef hdma_adc1;

I2C_HandleTypeDef hi2c1;

/* USER CODE BEGIN PV */
const float air_humidity=3400;
const  float water_humidity=1680;
uint16_t adc_buf[2];
uint8_t key;
float humidity;
char msg[10];
char set_humidity[10];

uint16_t set_value=20;

/* USER CODE END PV */

void SystemClock_Config(void);
static void MX_GPIO_Init(void);
static void MX_DMA_Init(void);
static void MX_ADC1_Init(void);
static void MX_I2C1_Init(void);
/* USER CODE BEGIN 0 */
void humidity_read();
void lcd();
void humidity_run(float humidity);
/* USER CODE END 0 */

/**
  * @brief  The application entry point.
  * @retval int
  */
int main(void)
{
  /* MCU Configuration--------------------------------------------------------*/

  /* Reset of all peripherals, Initializes the Flash interface and the Systick. */
  HAL_Init();

  /* Configure the system clock */
  SystemClock_Config();

  /* Initialize all configured peripherals */
  MX_GPIO_Init();
  MX_DMA_Init();
  MX_ADC1_Init();
  MX_I2C1_Init();
  /* USER CODE BEGIN 2 */
  lcd_init();
  HAL_ADC_Start_DMA(&hadc1, adc_buf, 2);
  lcd_send_cmd(0x80);

  /* USER CODE END 2 */

  /* Infinite loop */
  /* USER CODE BEGIN WHILE */
  while (1)
  {
    /* USER CODE END WHILE */

    /* USER CODE BEGIN 3 */
	  humidity_read();
	  HAL_Delay(100);
	  lcd();
	  humidity_run(humidity);
  }
  /* USER CODE END 3 */
}

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
/* USER CODE BEGIN 4 */
void humidity_read()
{
	           humidity= adc_buf[0];
		       if( humidity>air_humidity)
		       {
		    	   humidity=0;
		       }

		       else if( water_humidity<humidity&&humidity< air_humidity)
		       {

		    	   humidity=(1-(humidity-water_humidity)/(air_humidity-water_humidity))*100;
		       }
		       else
		       {
		    	   humidity=100;

		       }

		       sprintf(msg,"%.1f%%", humidity);

}
/*void data_transmit()
{
	   char data[10];
	   sprintf(data,"%.1f", humidity);
	   HAL_UART_Transmit(&huart3,data,strlen((char *)data),1000);
	   cliBufferTX[0]=',';
	   HAL_UART_Transmit(&huart3,cliBufferTX,strlen((char *)cliBufferTX),200);
	   HAL_UART_Transmit(&huart3,msg1,strlen((char *)msg1),1000);
	   cliBufferTX[0]='\n';
	   HAL_UART_Transmit(&huart3,cliBufferTX,strlen((char *)cliBufferTX),200);
}*/

void lcd()
{

    lcd_clear();
    lcd_put_cur(0,0);
	lcd_send_string("humidity:");
	lcd_send_string(msg);
	HAL_Delay(1000);

	key=read_keypad();
	if(key=='2')
	{
	  lcd_put_cur(1,0);
	  lcd_send_data(key);
	  HAL_Delay(1000);
	  lcd_clear();
	  lcd_put_cur(0,0);
	  lcd_send_string("set the humidity:");
	  lcd_put_cur(1,0);

	  int i=0;
	  int temp=1;

	  while(key!='*')
	   {
	    	    key=read_keypad();
	    	    set_value=0;
	    	    if(key!='E')
	    	    {
	               lcd_send_data(key);
	               set_humidity[i]=key;
	               i++;
	    	    }
	    	    HAL_Delay(1000);

	    	    if(key=='*')
	    	         {
	    	    	   int counter=0;
	    	    	   int flag=0;
	    	    	   while(set_humidity[flag]!='*')
	    	    	   {
	    	    		   flag++;
	    	    		  counter++;
	    	    	   }
	    	    	   for(int j=0;j<=counter-1;j++)
	    	    	   {


	    	    		   set_value+=(set_humidity[counter-1-j]-'0')*temp;
	    	              temp=temp*10;
	    	    	   }

	    	    	   lcd_clear();
	    	    	   lcd_put_cur(0,0);

	    	         }
	         }
	         HAL_Delay(1000);
	         key=' ';
		  }


}

void humidity_run(float humidity)
{

	              HAL_GPIO_WritePin(GPIOB,GPIO_PIN_0,GPIO_PIN_RESET);
			       if(humidity<set_value)
			       {

			    	   HAL_GPIO_WritePin(GPIOA,GPIO_PIN_4,GPIO_PIN_SET);
			       }

			       else if(humidity>=set_value)
				   {
			    	   HAL_GPIO_WritePin(GPIOA,GPIO_PIN_4,GPIO_PIN_RESET);
				   }

}
/* USER CODE END 4 */
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
