kele8864879/ENEL417-Group8-/(commit log)

2021-01-14 DMA代码
    存在Project文件夹里，自行采用
2021-01-21 distance sensor update
2021-03-29 circuit update
